Roman98nsk/Finaly-QW/Документация/Изображения/IMG_7211.JPG

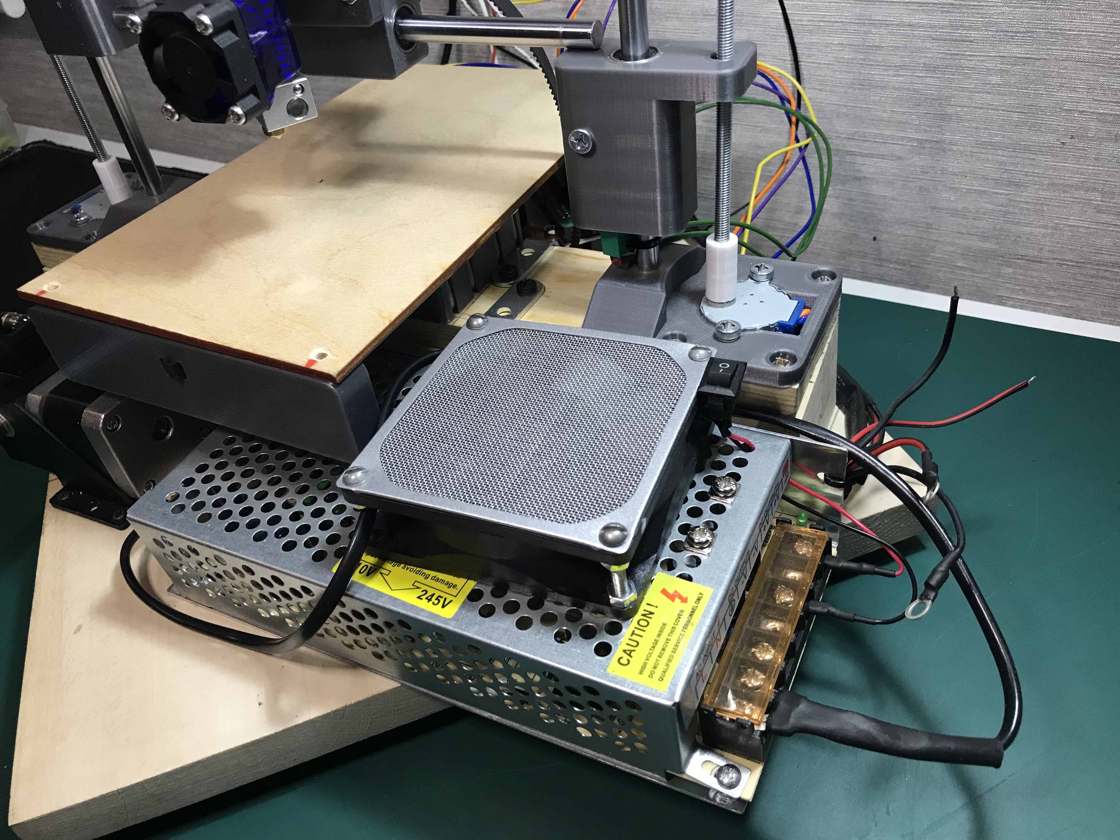
Документация/Изображения/IMG_7211.JPG
