Roman98nsk/Finaly-QW/Документация/Изображения/Термистор.png

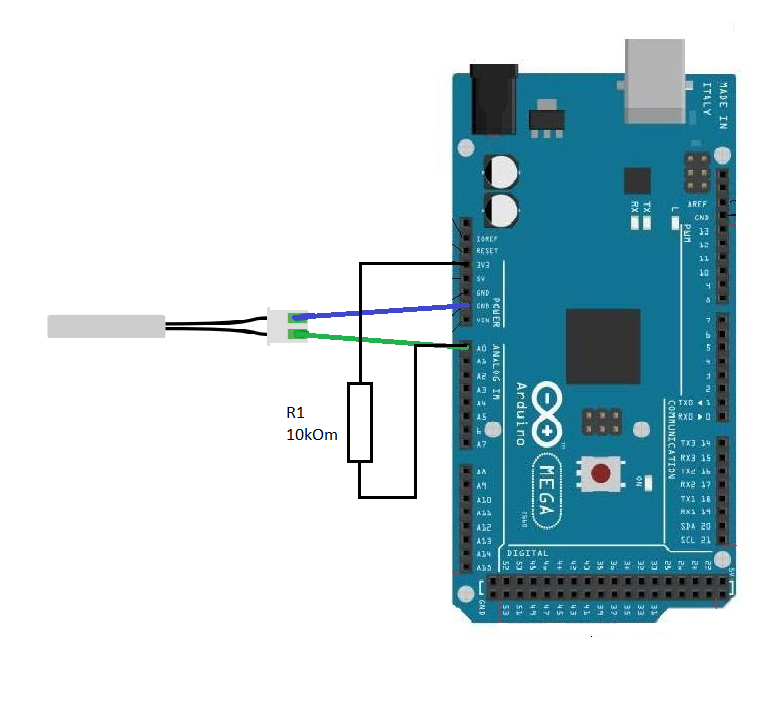
Документация/Изображения/Термистор.png
