Roman98nsk/Finaly-QW/Документация/Изображения/IMG_7209.JPG

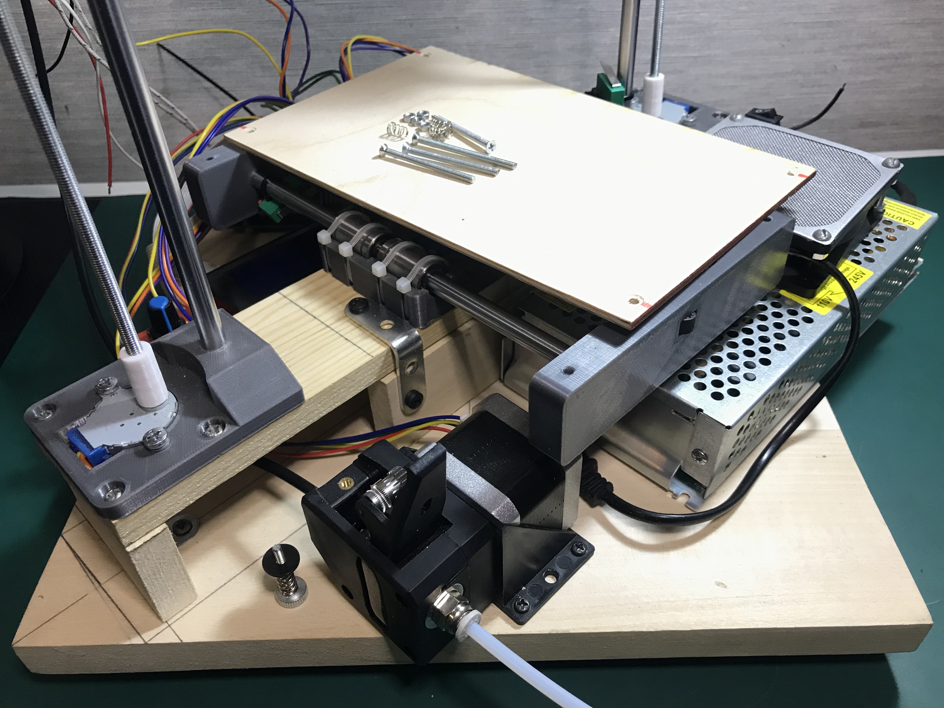
Документация/Изображения/IMG_7209.JPG
