Roman98nsk/Finaly-QW/Документация/Изображения/IMG_7213.JPG

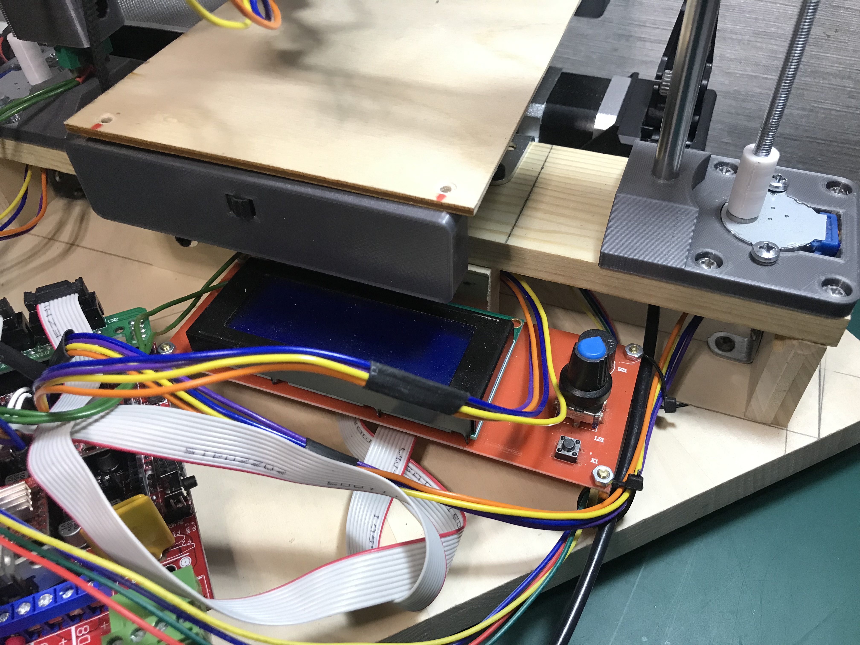
Документация/Изображения/IMG_7213.JPG
