Roman98nsk/Finaly-QW/Документация/Изображения/LCD дисплей.jpg

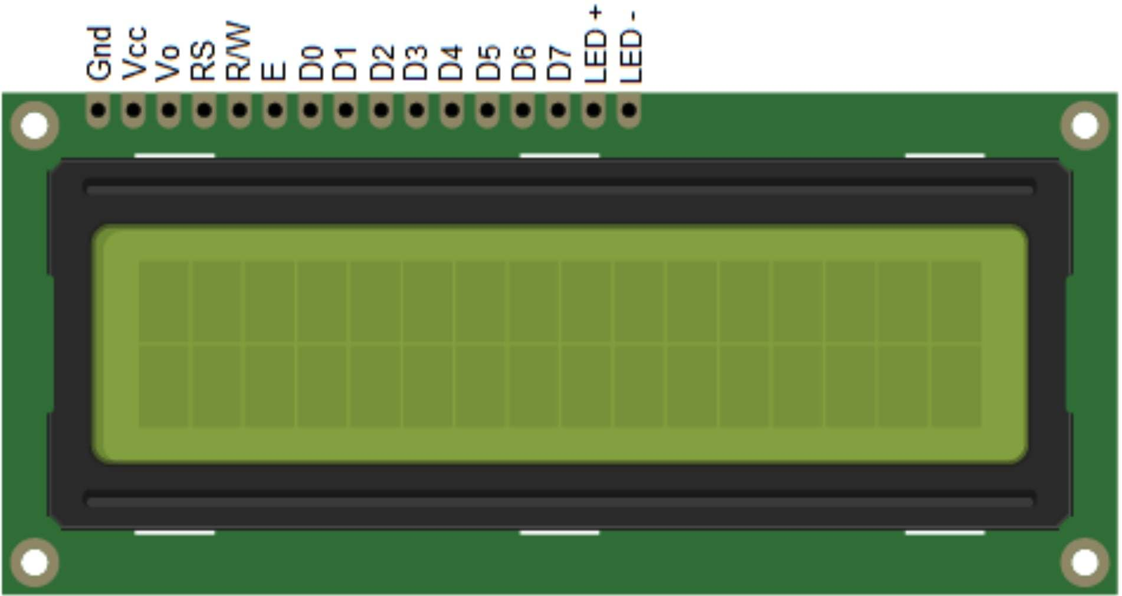
Документация/Изображения/LCD дисплей.jpg
