Roman98nsk/Finaly-QW/Документация/Изображения/Smart adapter LCD.PNG

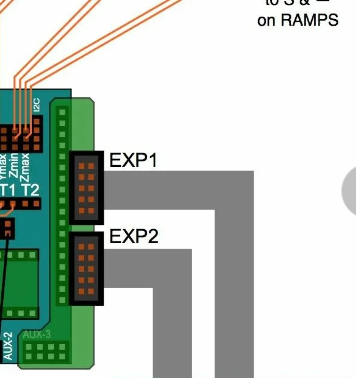
Документация/Изображения/Smart adapter LCD.PNG
