Roman98nsk/Finaly-QW/Документация/Изображения/Агрегаты ramps1.4.jpg

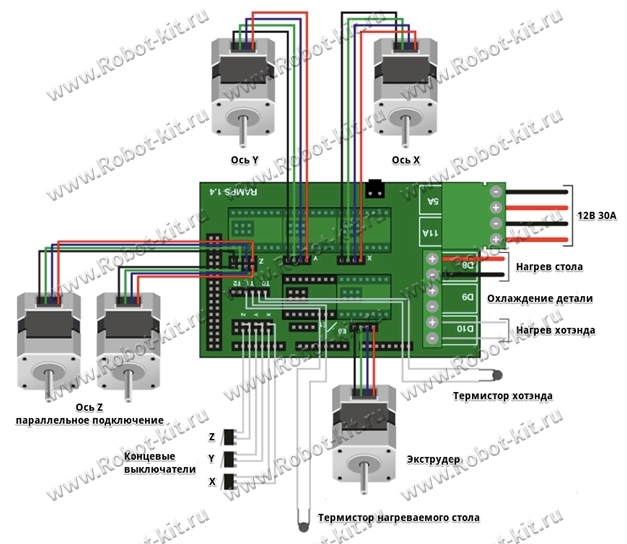
Документация/Изображения/Агрегаты ramps1.4.jpg
