Roman98nsk/Finaly-QW/Документация/Изображения/Пины ramps1.4.jpg

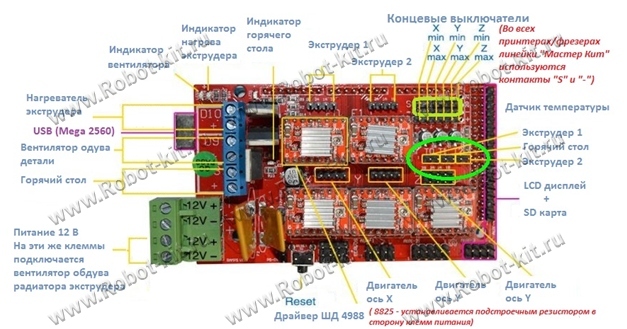
Документация/Изображения/Пины ramps1.4.jpg
