Roman98nsk/Finaly-QW/Документация/Изображения/Пины а4988.jpg

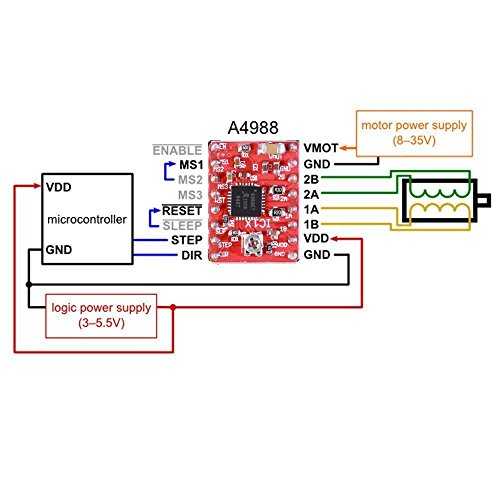
Документация/Изображения/Пины а4988.jpg
