Roman98nsk/Finaly-QW/Документация/Изображения/Пример схемы.jpg

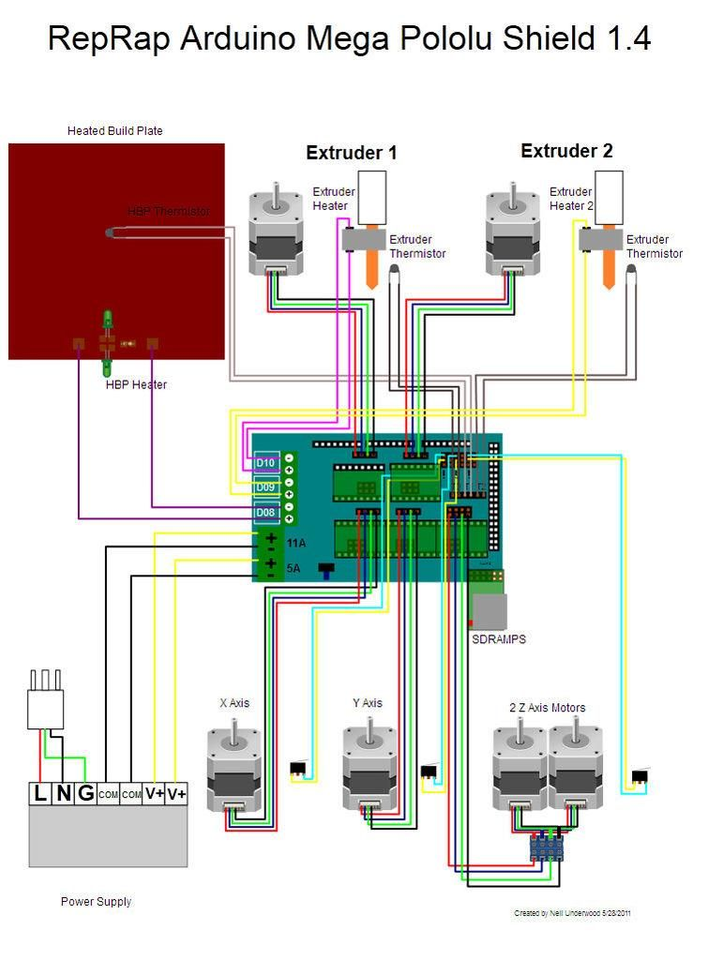
Документация/Изображения/Пример схемы.jpg
