Roman98nsk/Finaly-QW/Документация/Изображения/Схема принтера.png

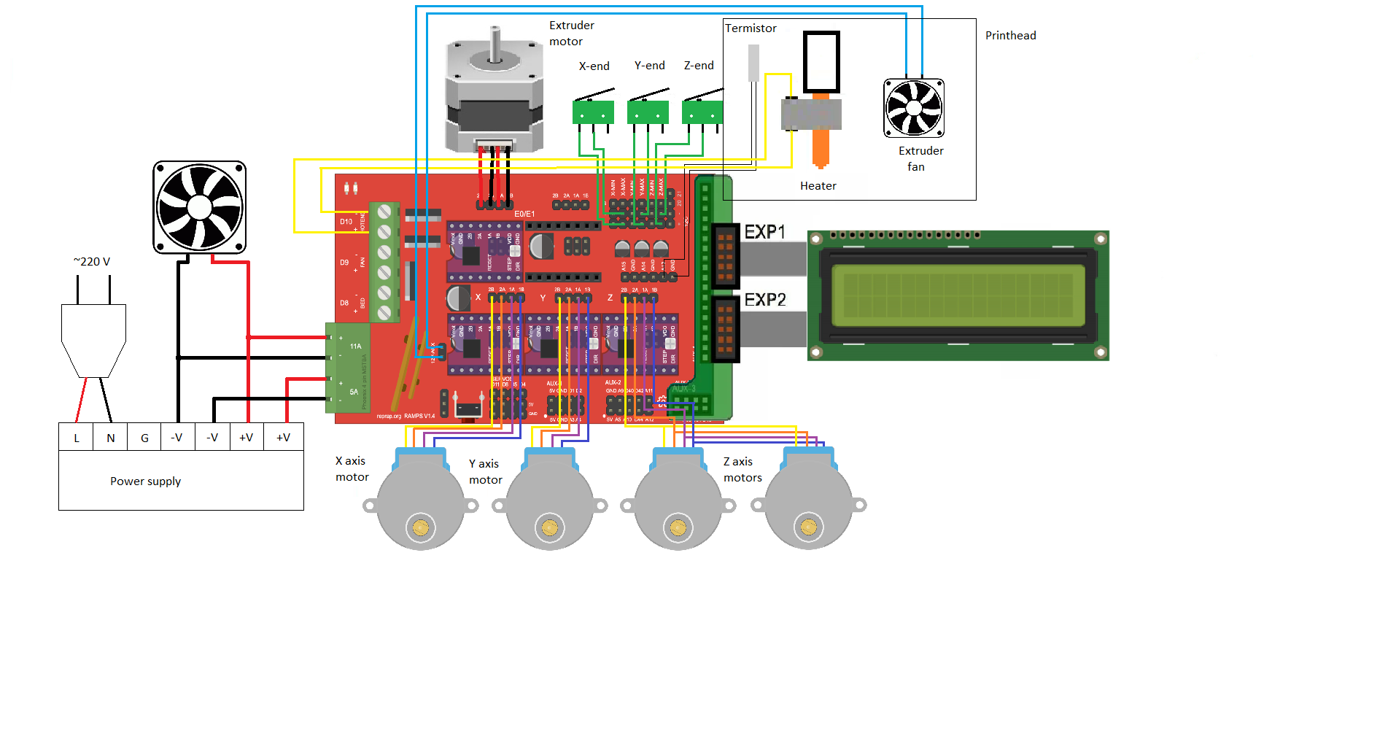
Документация/Изображения/Схема принтера.png
