Roman98nsk/Finaly-QW/Документация/Изображения/Установка шага.jpg

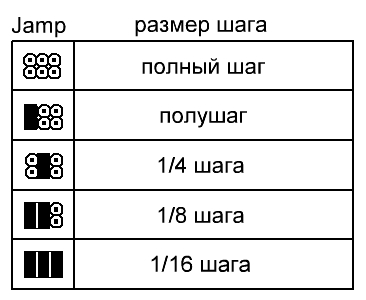
Документация/Изображения/Установка шага.jpg
