Roman98nsk/Finaly-QW/Документация/Изображения/Файлы для печати/Куб.scad

cube(size=[10,10,10], center = true);
