Roman98nsk/Finaly-QW/(notices)

Notices in the files:
Приложение/Marlin/Configuration_adv.h:
define TOUCH_UI_UTF8_COPYRIGHT // © ®
